kiqdestro/mirrorHand/README.md

# mirrorHand
Mechanical hand that reproduces real hand movements through a data glove input
