kiqdestro/mirrorHand/index.md

<!-- # [Mirror Hand](index.md) -->

## Uma luva capturadora de movimentos usando sensores óticos de flexão e replicação dos movimentos capturados utilizando mão robótica.

### Integrantes:

 - Caíque Destro (1658930) - caiquedestro@gmail.com

 - João Carlos Cardoso dos Santos (1371916) - jc.cardoso4@gmail.com

### Cronograma:

 - [Cronograma](https://docs.google.com/spreadsheets/d/1rPYKbOurIVPeYO_swWk3HFBk6oQO6jvVg92YagprTJc/edit?usp=sharing)
 
### Relatório Final:

 - [Relatório Final](Relat_rio_final___MirrorHand_rev1.pdf)
 
### Apresentação Final:

<iframe src="https://docs.google.com/presentation/d/e/2PACX-1vRj9GQ2ZhSmLDQJI-fFzHOCION43njDvBKpqKeW56N2M8A0PVf-mFP5k_aZYg3UYceGSj01armufjrE/embed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" frameborder="0" width="512" height="294" allowfullscreen="true" mozallowfullscreen="true" webkitallowfullscreen="true"></iframe>

## O Projeto:

 - [Introdução](introducao.md)
 - [Componentes](componentes.md)
 - [Luva](luvafinal.md)
 - [Mão Mecânica](maomecanicafinal.md)
 - [Software e integração](SoftwareInt.md)
 
## Demonstração:

<video src="demonstracao1.webm" width="512" height="294" controls preload></video>

<br>

## Diagrama de blocos:

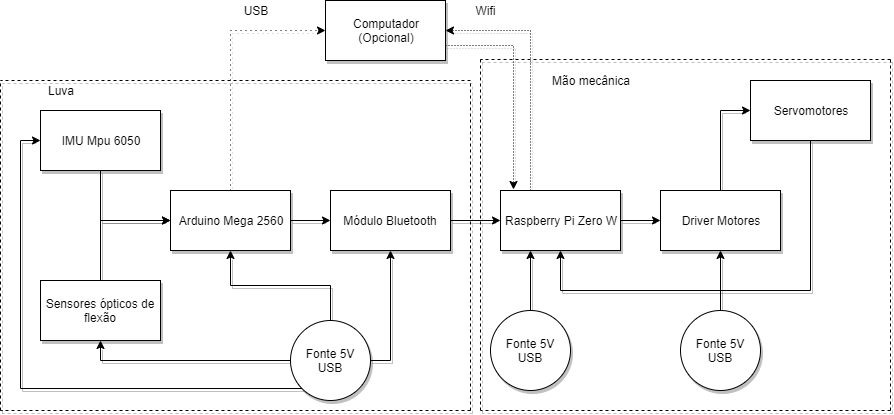
[picture p13: diagramas/diagramadeblocos.png]
diagramadeblocos


## Pré-Projeto:

 - [Pré-projeto](preprojeto.md)
 - [Luva(Pré-projeto)](luva.md)
 - [Mão Robótica(Pré-projeto)](maomecanica.md)

### Apresentação pré-projeto:

<iframe src="https://docs.google.com/presentation/d/e/2PACX-1vRffG2Q6gzKz5Kw5BDXvtA4HoA5tJwQld_cZXNodl7iY-V_7_jIz_v5gzBc4bYqyP8XAek6BO6x0ram/embed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" frameborder="0" width="512" height="294" allowfullscreen="true" mozallowfullscreen="true" webkitallowfullscreen="true"></iframe>
