kiqdestro/mirrorHand/progresso.md

<!-- # [Mirror Hand](index.md) -->

## Luva de dados

## Mão mecânica

## Interfaceamento
