kiqdestro/mirrorHand/presentation.md

## Uma luva capturadora de movimentos usando sensores óticos de flexão e replicação dos movimentos capturados utilizando mão robótica.

### Integrantes

 - Caíque Destro (1658930) - caiquedestro@gmail.com

 - João Carlos Cardoso dos Santos (1371916) - jc.cardoso4@gmail.com
 
 <iframe src="https://docs.google.com/presentation/d/e/2PACX-1vRffG2Q6gzKz5Kw5BDXvtA4HoA5tJwQld_cZXNodl7iY-V_7_jIz_v5gzBc4bYqyP8XAek6BO6x0ram/embed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" frameborder="0" width="864" height="512" allowfullscreen="true" mozallowfullscreen="true" webkitallowfullscreen="true"></iframe>

## Link para apresentação
- [Presentation](https://docs.google.com/presentation/d/e/2PACX-1vRffG2Q6gzKz5Kw5BDXvtA4HoA5tJwQld_cZXNodl7iY-V_7_jIz_v5gzBc4bYqyP8XAek6BO6x0ram/pub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)
