kiqdestro/mirrorHand/luva/maoparcial4.jpeg

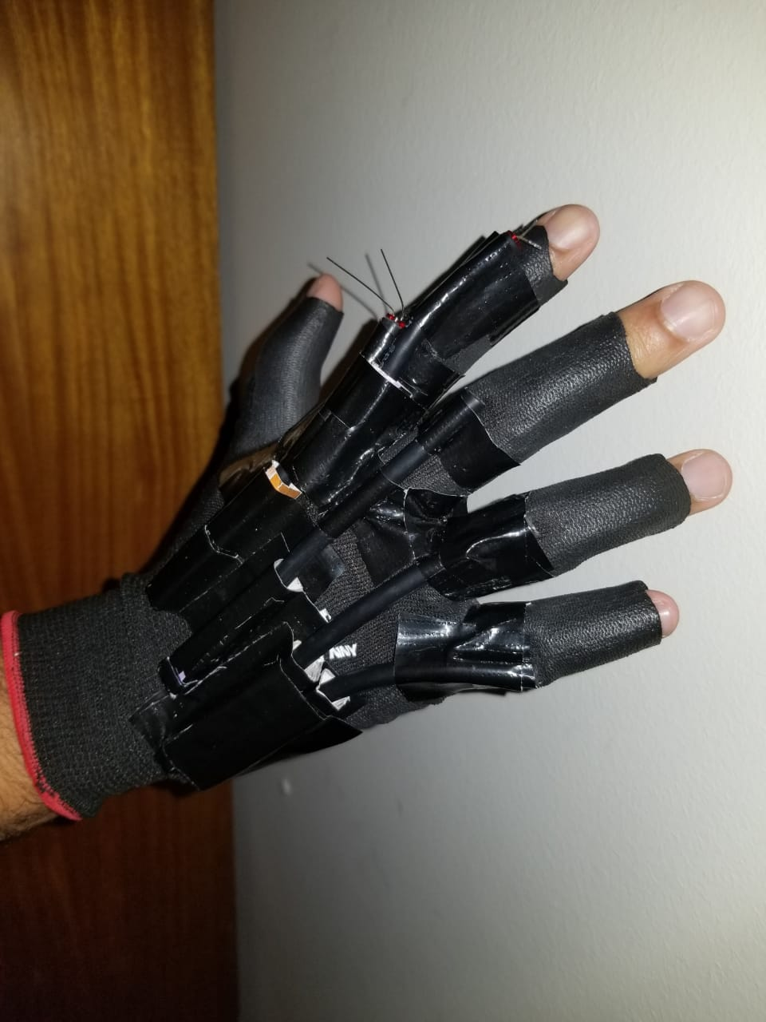
luva/maoparcial4.jpeg
