kiqdestro/mirrorHand/maorobotica/maoparcial2.jpg

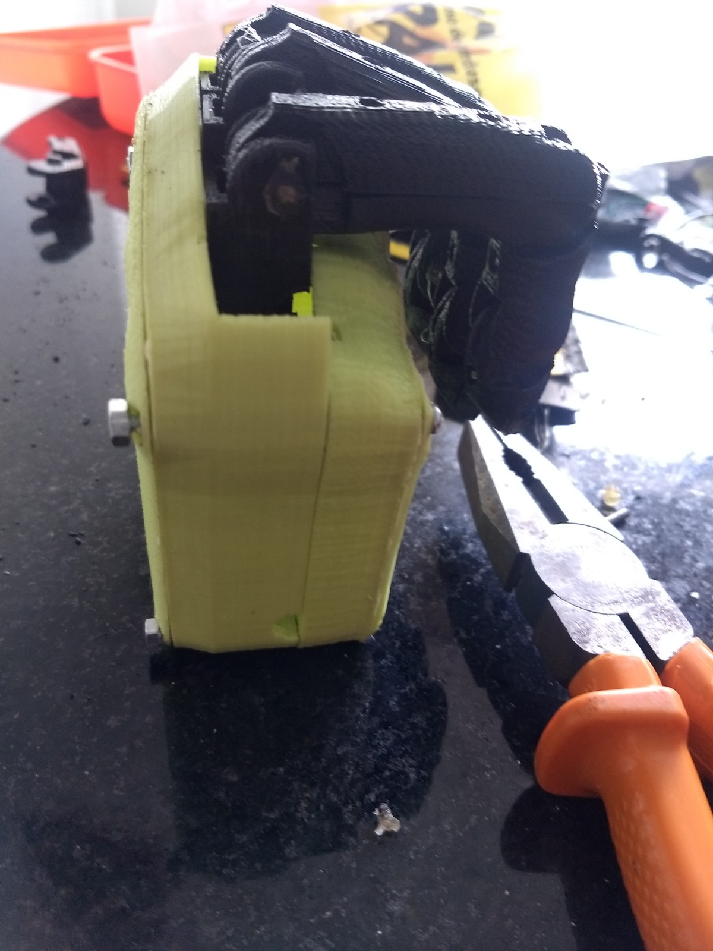
maorobotica/maoparcial2.jpg
