kiqdestro/mirrorHand/mechate_hand.jpg

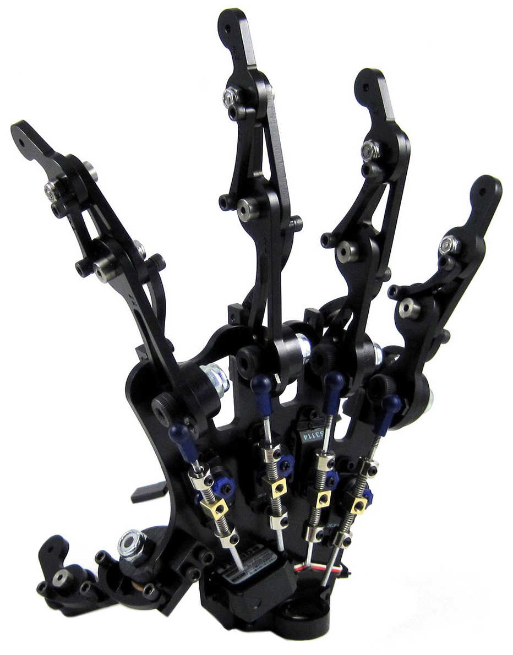
mechate_hand.jpg
