kiqdestro/mirrorHand/MirrorHandPi/jointlabels.png

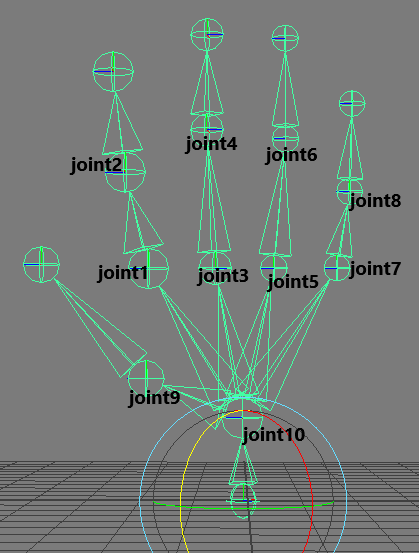
MirrorHandPi/jointlabels.png
