kiqdestro/mirrorHand/componentes/ldrcurve.JPG

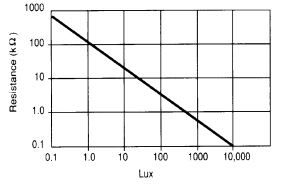
componentes/ldrcurve.JPG
