kiqdestro/mirrorHand/componentes/PCA8956Features.png

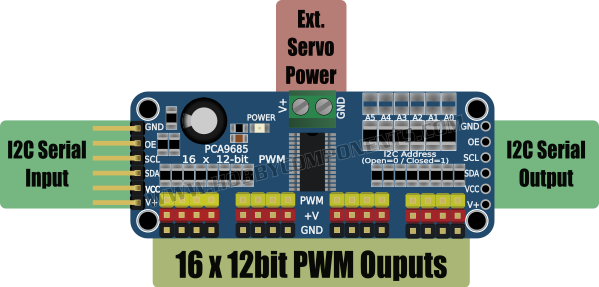
componentes/PCA8956Features.png
