kiqdestro/mirrorHand/gloveRead/serialinput.py

#Serial read module for MirrorHand software
#Joao Carlos Cardoso - 2019

import serial
import time

no_fucking_extra_outputs = True


ARDUINO = "/dev/rfcomm0"
#PI = "COM6"
#SerialOutput = serial.Serial(PI, baudrate=115200, timeout = 1, bytesize=8, parity='N', stopbits=1)

#ARDUINO = "/dev/ttyAMA0"
#
#>>>>>>> 759ba770ad7c9119ac8009bfc86c13e9fdee6b8c
Sensor = [0]*13

#Read multiple inputs from serial port


def InitSerial():
# <<<<<<< HEAD
#     SerialInput = serial.Serial(ARDUINO, 115200)
# =======
    #SerialInput = serial.Serial(ARDUINO, 9600)
    SerialInput = serial.Serial(ARDUINO, baudrate=9600, timeout = 1)
#>>>>>>> IMU
    return SerialInput

def Read(SerialInput):
    char = SerialInput.read()
    #print(char)
    #written = SerialOutput.write(char)
    return char

def ReadSerial(SerialInput):
    try:
        SerialInput.flush()
        char = Read(SerialInput)
        String = ''
        while (char != '\t'.encode('utf-8')):
            char = Read(SerialInput)
        String = String + char.decode()
        while(char != '\n'.encode('utf-8')):
            String = String + char.decode()
            char = Read(SerialInput)
        String = String + char.decode()
        
        if(not no_fucking_extra_outputs):
            print(String)

        i = 0
        while (String[i] != "\n"):
            #print(String[i])
            SensorValue = ""
            CurrentSensor = ""
            while(String[i] != ">"):
                #print(String[i])
                i = i+1
            if(String[i] == ">"):
                i = i+1
                while(String[i] != "$"):
                    CurrentSensor = CurrentSensor + String[i]
                    i = i+1
                #print(CurrentSensor)
            if(String[i] == "$"):
                i = i+1
                while(String[i] != "<"):
                    SensorValue = SensorValue + String[i]
                    i = i+1
            i = i+1
            Sensor[int(CurrentSensor)] = int(float(SensorValue))
            #print (CurrentSensor, SensorValue, sep = " - ")
        #print (Sensor)
        return Sensor
    except:
        pass       

    
     
        """ SerialData = SerialInput.read(1).decode("utf-8")
        print (SerialData)
        while (SerialData != '>'):
            SerialData = SerialInput.read(1).decode()
            print(SerialData)
        SensorNumber = int(SerialInput.read(1))
        print(SerialData)
        if(SerialInput.read(1).decode("utf-8") == '-'):
            while (SerialData != '<'):
                SerialData = SerialInput.read(1).decode("utf-8")
                print(SerialData)
                if(SerialData != '<'):
                    SensorValue = SensorValue + SerialData
        Sensor = (SensorNumber, int(SensorValue))
        print (Sensor)
        return Sensor """


"""def ReadSensors(SerialLine):
    value = 0
    Sensors = [0] * 10"""

"""    try:
        if (SerialLine =)
    except ValueError:
        return Sensors"""


"""    try:                            #Tratamento de excecao e de erro caso a serial receba uma string errada
        index = int(SerialLine[3:4]) #safe cast para int
    except ValueError:
        return Sensors         #Retorna valores antigos
    try:
        if (len(SerialLine) == 8):
            value = int(float(SerialLine[5:8])) 
    except ValueError:
        pass
    try:
        if (len(SerialLine) == 7):
            value = int(float(SerialLine[5:7])) #Se nao der certo para 3 algarismos tenta para 2, senao retorna o valor antigo
    except ValueError:
        return Sensors
    try:
        Sensors[index] = value
    except ValueError:
        return Sensors
    return Sensors"""
