kiqdestro/mirrorHand/(commit log)

2019-09-04 Insercao de integrantes
2019-09-09 Example images inserted
2019-09-10 Criado arquivo do template para poder customizar os detalhes na lateral
2019-09-10 Adiocionada apresentação de slides
2019-09-10 Adicionados links para luva e mao mecanica no cabecalho lateral
2019-11-16 Servo control file added
2019-11-17 Control directly from Raspberry
2019-11-20 Alteracoes para implementar IMU
2019-11-20 Implementa IMU Software. New serial handling and sensor data i/o
2019-11-25 Change in serial print arduino
2019-11-25 readline at the end fixed
    [final.py]
2019-11-26 Added IMU to arduino code, added maya.py
2019-11-27 testing fingers movements
